ThisIsNotRocketScience/TinyGame/README.md

# TinyGame
A very very small gaming device. 
Based on a Freescale/NXP KL02 microcontroller, a 64x32 pixel black/white OLED display.
Firmware updatable through the audio jack

Soon available on www.thisisnotrocketscience.nl 

Follow our progress on [twitter](https://twitter.com/rocket_not)
