ThisIsNotRocketScience/TinyGame/ArtWork.bmp

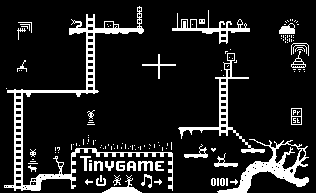
ArtWork.bmp
