ThisIsNotRocketScience/TinyGame/Design Related/Box Sleeve Design.pdf

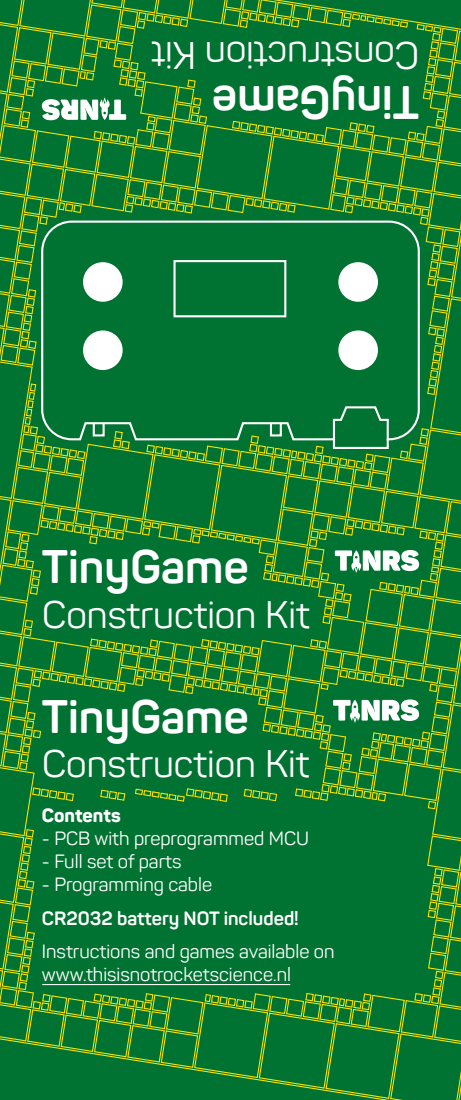
[picture p2: page 1]
TinyGame; Construction Kit

Contents
- PCB with preprogrammed MCU
- Full set of parts
- Programming cable
CR2032 battery NOT included!
Instructions and games available on
www.thisisnotrocketscience.nl
