ThisIsNotRocketScience/TinyGame/TinyCam.brd

## EAGLE design TinyCam.brd (2016-12-25)

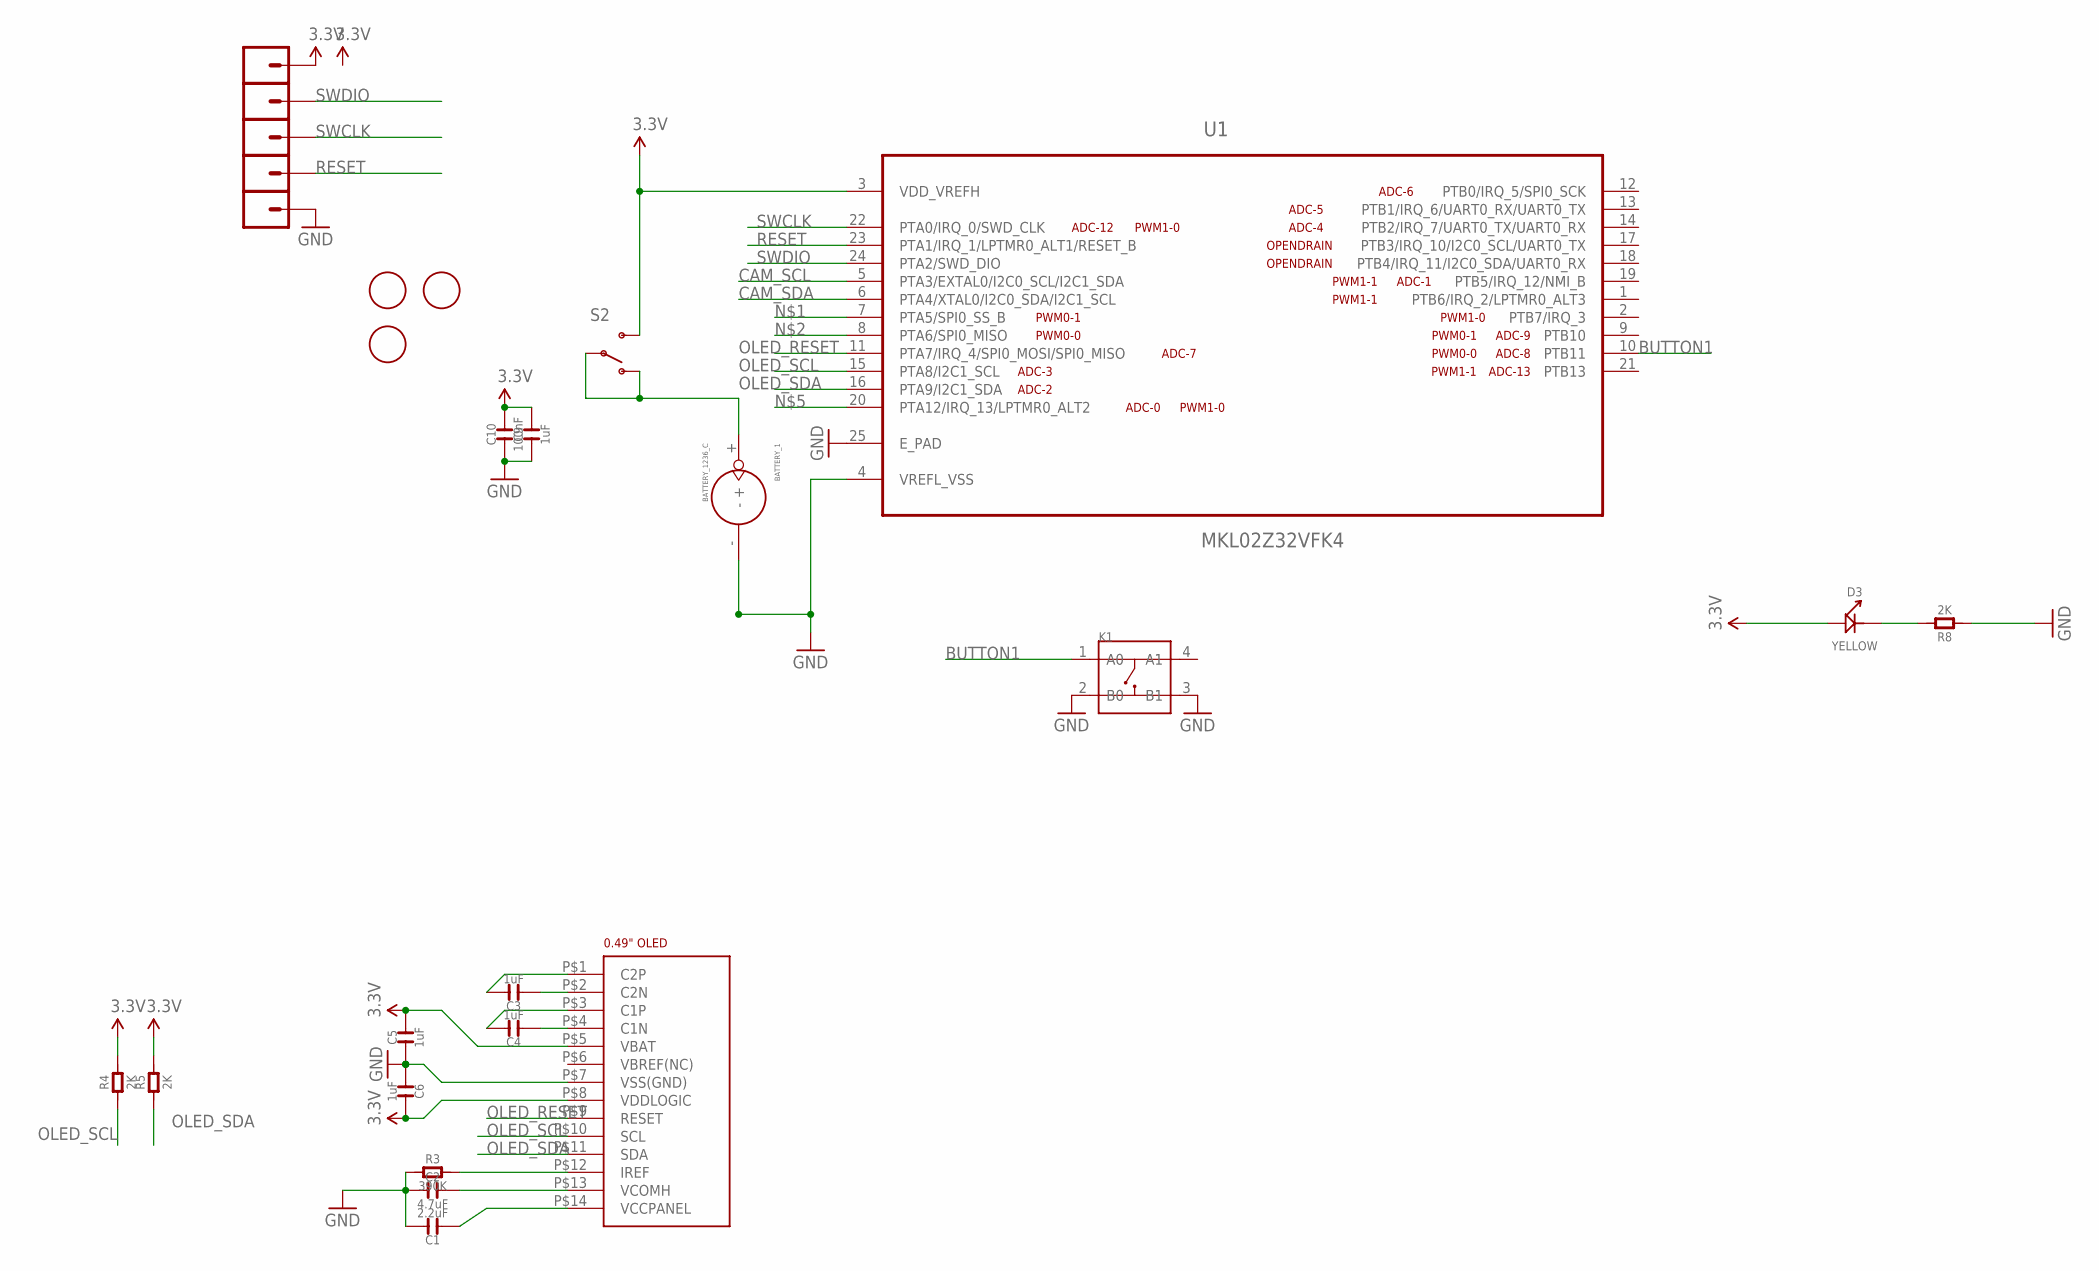
[picture p3: schematic TinyCam.sch]

Parts:
BATTERY_1: BATTERY_1236_C
C1: 2.2uF; C0603
C2: 4.7uF; C0603
C3, C4, C5, C6, C9: 1uF; C0603
C10: 100nF; C0603
D3: YELLOW; LED0603
K1: BUTTON-4P-3100010P1; 4P-SMD-6.0X6.0X5.0H
PTA6_MISO1, PTA6_MISO2, PTA6_MISO3, PTA6_MISO4, PTA6_MISO5: M01SMD-4.5X1.5; PAD-1.5X4.5
R3: 390K; R0603
R4, R5, R8: 2K; R0603
S2: SWITCH-SPDT-SMD-A; SWITCH-SPST-SMD-A
U1: MKL02Z32VFK4; QFN50P400X400X100-25N
U$1: 0.49"OLEDFOLDED; 0.49"-FPC-0.7-14-FOLDED
U$2, U$3, U$4: FIDUCIAL; FIDUCIAL_1MM

Connections:
3.3V: C5.2, C6.2, C9.2, C10.2, D3.+, PTA6_MISO1.P$1, R4.2, R5.2, S2.3 (S), U1.3 (VDD_VREFH), U$1.P$5 (VBAT), U$1.P$8 (VDDLOGIC)
BUTTON1: K1.1 (A0), U1.10 (PTB11)
CAM_SCL: U1.5 (PTA3/EXTAL0/I2C0_SCL/I2C1_SDA)
CAM_SDA: U1.6 (PTA4/XTAL0/I2C0_SDA/I2C1_SCL)
GND: BATTERY_1.-, C1.2, C2.1, C5.1, C6.1, C9.1, C10.1, K1.2 (B0), K1.3 (B1), PTA6_MISO5.P$1, R3.1, R8.1, U1.4 (VREFL_VSS), U1.25 (E_PAD), U$1.P$7 (VSS(GND))
unnamed: C3.2, U$1.P$1 (C2P)
unnamed: C4.2, U$1.P$3 (C1P)
unnamed: R3.2, U$1.P$12 (IREF)
unnamed: C1.1, U$1.P$14 (VCCPANEL)
unnamed: C2.2, U$1.P$13 (VCOMH)
unnamed: C3.1, U$1.P$2 (C2N)
unnamed: C4.1, U$1.P$4 (C1N)
unnamed: D3.-, R8.2
OLED_RESET: U1.11 (PTA7/IRQ_4/SPI0_MOSI/SPI0_MISO), U$1.P$9 (RESET)
OLED_SCL: R4.1, U1.15 (PTA8/I2C1_SCL), U$1.P$10 (SCL)
OLED_SDA: R5.1, U1.16 (PTA9/I2C1_SDA), U$1.P$11 (SDA)
RESET: PTA6_MISO4.P$1, U1.23 (PTA1/IRQ_1/LPTMR0_ALT1/RESET_B)
SWCLK: PTA6_MISO3.P$1, U1.22 (PTA0/IRQ_0/SWD_CLK)
SWDIO: PTA6_MISO2.P$1, U1.24 (PTA2/SWD_DIO)
VBAT: BATTERY_1.+, S2.1 (O), S2.2

Board: 2 copper layers, 26 parts (0 on the bottom side), 18 nets, no tracks yet.
