ThisIsNotRocketScience/TinyGame/TinyGame_RC1/TinyGame RC1_Jig.brd

## EAGLE design TinyGame_RC1/TinyGame RC1_Jig.brd (2016-12-03)

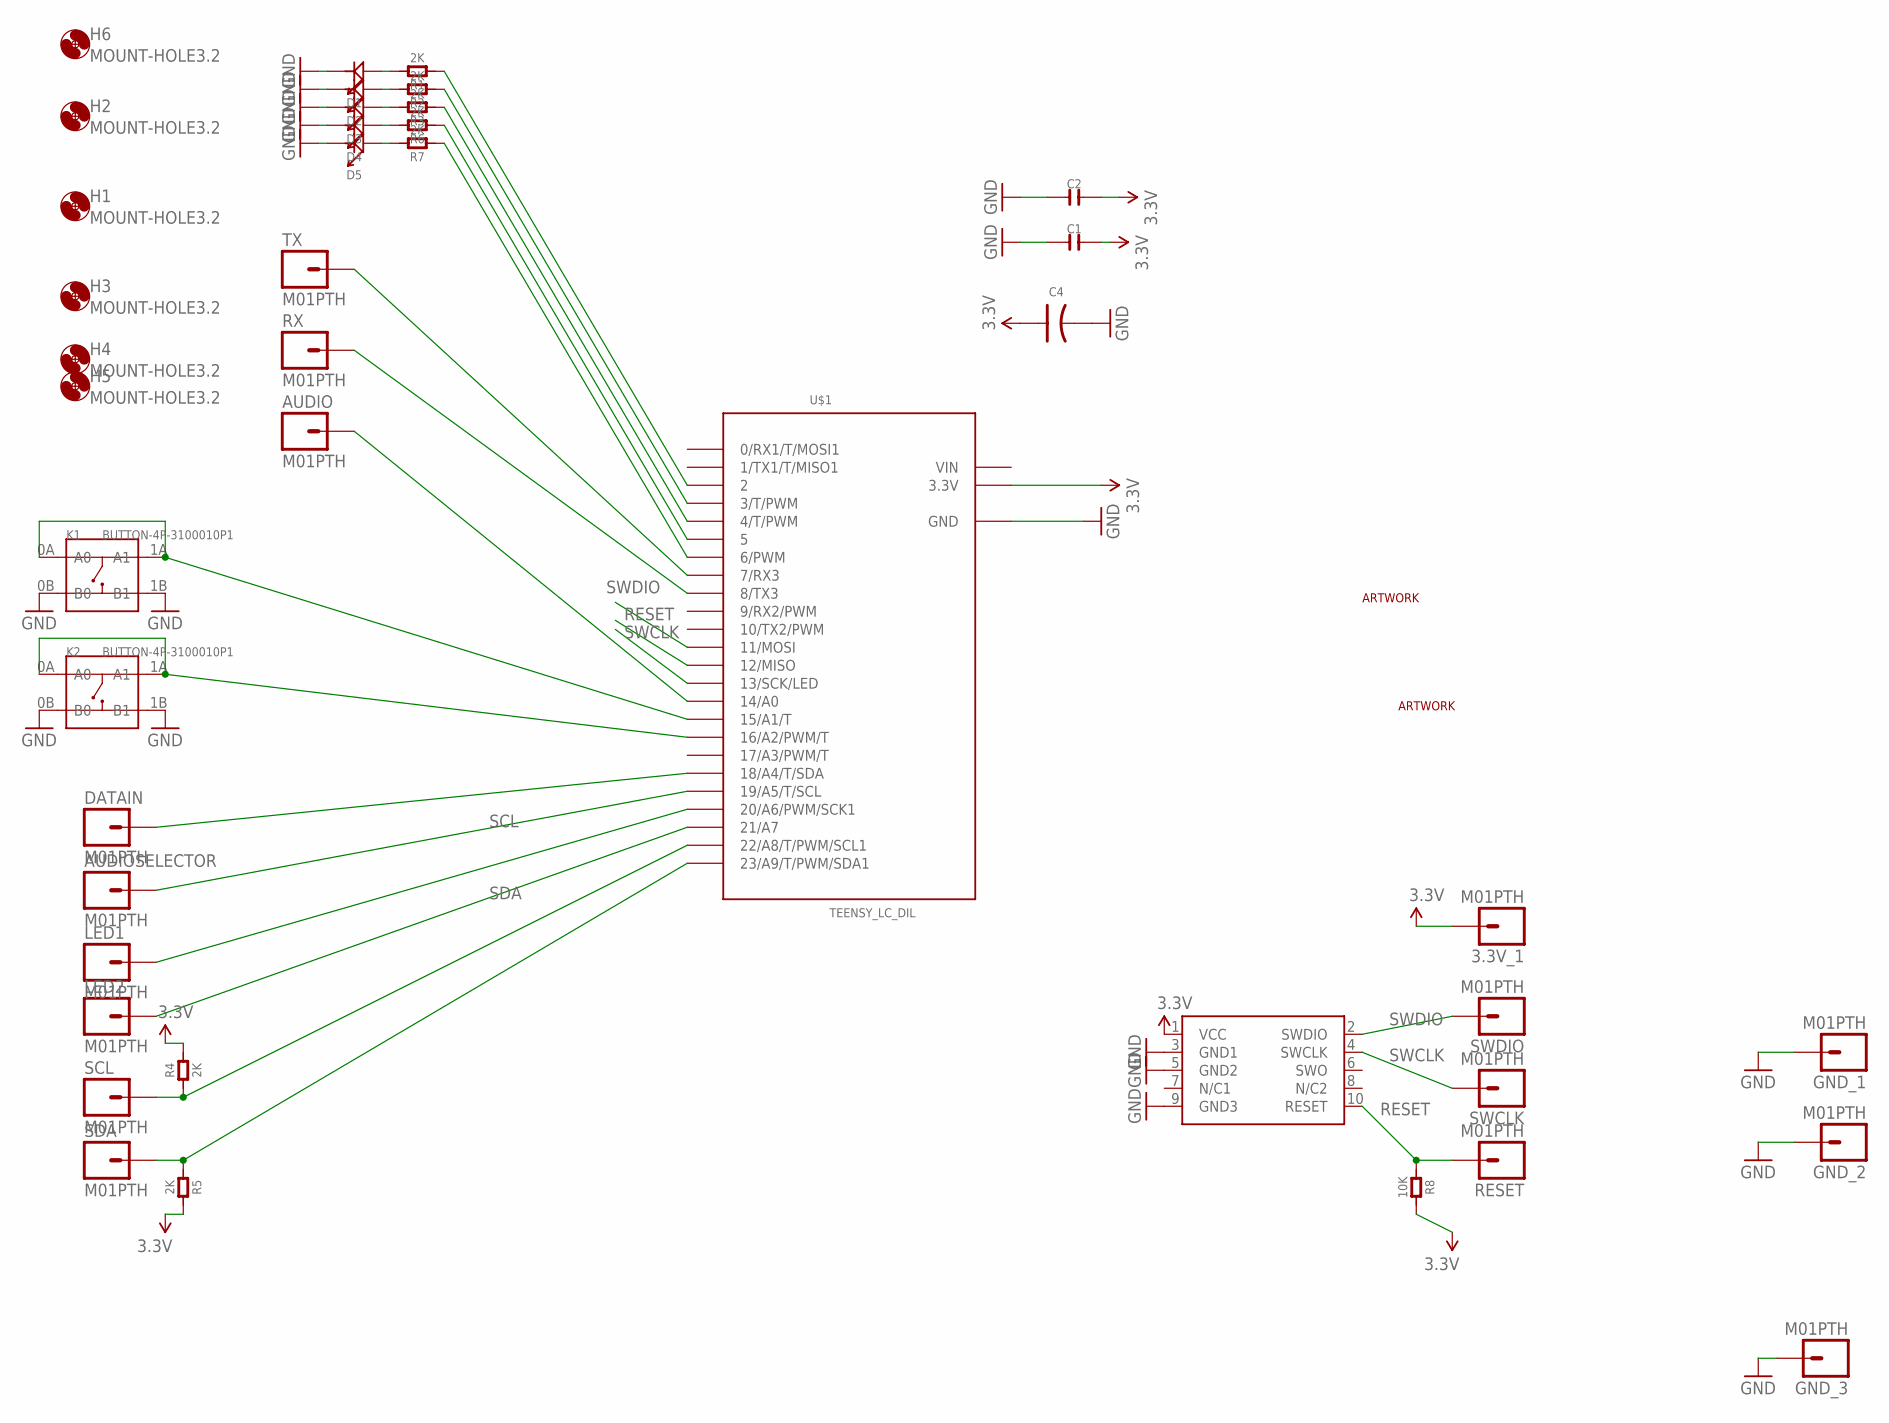
[picture p4: schematic TinyGame RC1_Jig.sch]

Parts:
3.3V_1: M01PTH; 1X01
AUDIO: M01PTH; 1X01
AUDIOSELECTOR: M01PTH; 1X01
C1, C2: C-0603; C0603
C4: C-POLAR-A; AVX-A
D1, D2, D3, D4, D5: LED; LED0603
DATAIN: M01PTH; 1X01
GND_1, GND_2, GND_3: M01PTH; 1X01
H1, H2, H3, H4, H5, H6: MOUNT-HOLE3.2; 3,2
K1, K2: BUTTON-4P-3100010P1; 4P-SMD-6.0X6.0X5.0H
LED1, LED2: M01PTH; 1X01
R1, R2, R3, R4, R5, R6, R7: 2K; R0603
R8: 10K; R0603
RESET: M01PTH; 1X01
RX: M01PTH; 1X01
SCL: M01PTH; 1X01
SDA: M01PTH; 1X01
SWCLK: M01PTH; 1X01
SWD1: CORTEX_SWDVERT; SWD_VERTICAL
SWDIO: M01PTH; 1X01
TX: M01PTH; 1X01
U$1: TEENSY_LC_DIL; TEENSY_3.0-3.2&LC_DIL
U$2: TINRS_ARTWORKLOGO; TINRSLOGO
U$3: TINRS_ARTWORKROCKET; TINRS_ROCKET

Connections:
3.3V: 3.3V_1.1, C1.2, C2.2, C4.+ (1), R4.2, R5.2, R8.2, SWD1.1 (VCC), U$1.3.3V
GND: C1.1, C2.1, C4.- (2), D1.-, D2.-, D3.-, D4.-, D5.-, GND_1.1, GND_2.1, GND_3.1, K1.0B (B0), K1.1B (B1), K2.0B (B0), K2.1B (B1), SWD1.3 (GND1), SWD1.5 (GND2), SWD1.9 (GND3), U$1.AGND (GND), U$1.GND
unnamed: TX.1, U$1.7 (7/RX3)
unnamed: RX.1, U$1.8 (8/TX3)
unnamed: AUDIO.1, U$1.14/A0
unnamed: LED2.1, U$1.21/A7
unnamed: LED1.1, U$1.20/A6 (20/A6/PWM/SCK1)
unnamed: AUDIOSELECTOR.1, U$1.19/A5 (19/A5/T/SCL)
unnamed: DATAIN.1, U$1.18/A4 (18/A4/T/SDA)
unnamed: R1.1, U$1.2
unnamed: R2.1, U$1.3 (3/T/PWM)
unnamed: R3.1, U$1.4 (4/T/PWM)
unnamed: R6.1, U$1.5
unnamed: R7.1, U$1.6 (6/PWM)
unnamed: D1.+, R1.2
unnamed: D2.+, R2.2
unnamed: D3.+, R3.2
unnamed: D4.+, R6.2
unnamed: D5.+, R7.2
unnamed: K1.0A (A0), K1.1A (A1), U$1.15/A1 (15/A1/T)
unnamed: K2.0A (A0), K2.1A (A1), U$1.16/A2 (16/A2/PWM/T)
RESET: R8.1, RESET.1, SWD1.10 (RESET), U$1.12 (12/MISO)
SCL: R4.1, SCL.1, U$1.22/A8 (22/A8/T/PWM/SCL1)
SDA: R5.1, SDA.1, U$1.23/A9 (23/A9/T/PWM/SDA1)
SWCLK: SWCLK.1, SWD1.4 (SWCLK), U$1.13 (13/SCK/LED)
SWDIO: SWD1.2 (SWDIO), SWDIO.1, U$1.11 (11/MOSI)
VIN: U$1.VIN

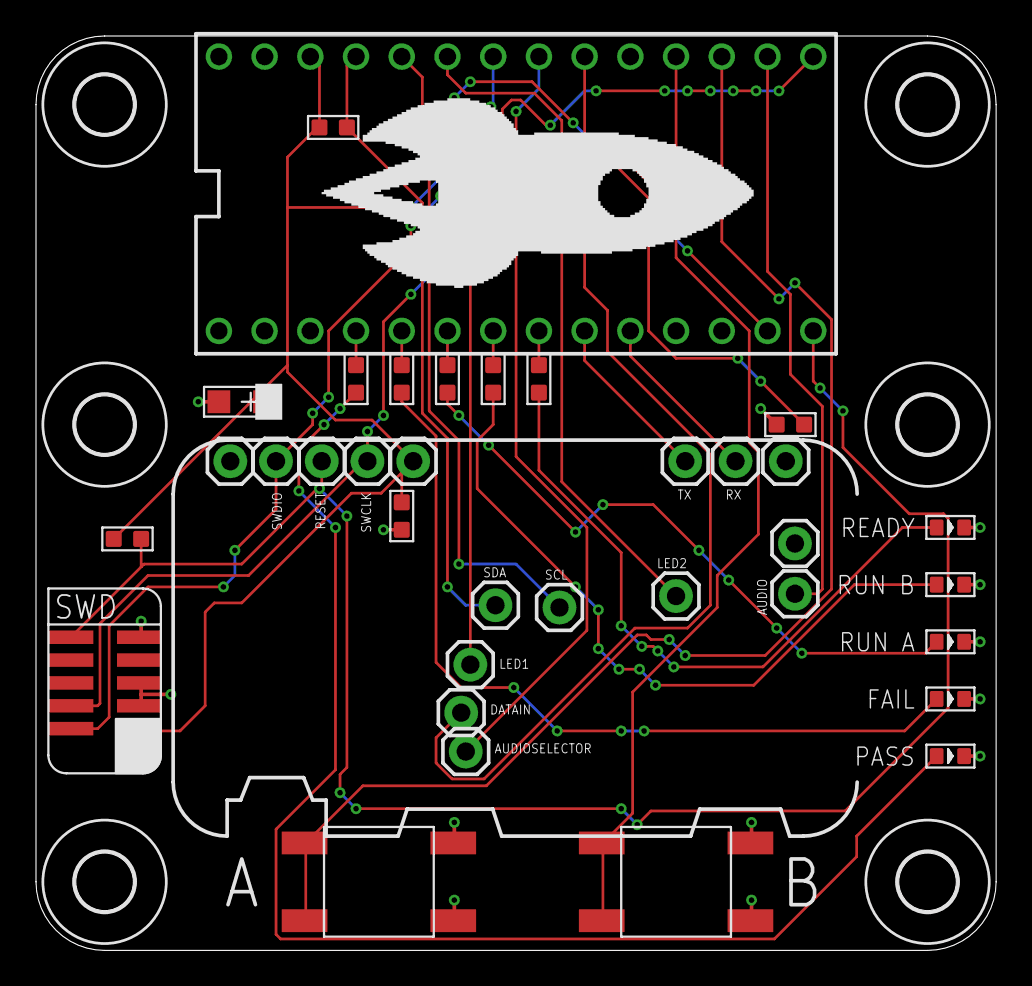
[picture p5: board TinyGame RC1_Jig.brd from above]

Board: 2 copper layers, 53.3 x 50.8 mm, 44 parts (1 on the bottom side), 26 nets.
