ThisIsNotRocketScience/TinyGame/TinyGame_RC1/TinyGame RC1_JTAG.brd

## EAGLE design TinyGame_RC1/TinyGame RC1_JTAG.brd (2016-12-03)

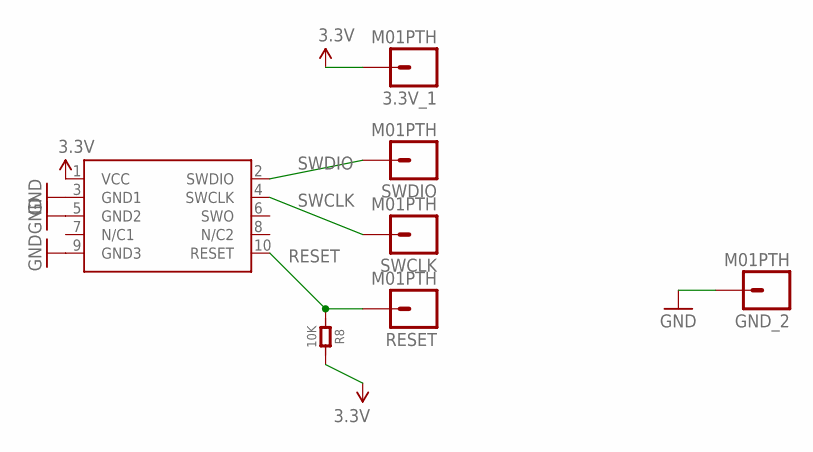
[picture p6: schematic TinyGame RC1_JTAG.sch]

Parts:
3.3V_1: M01PTH; 1X01
GND_2: M01PTH; 1X01
R8: 10K; R0603
RESET: M01PTH; 1X01
SWCLK: M01PTH; 1X01
SWD1: CORTEX_SWDVERT; SWD_VERTICAL
SWDIO: M01PTH; 1X01

Connections:
3.3V: 3.3V_1.1, R8.2, SWD1.1 (VCC)
GND: GND_2.1, SWD1.3 (GND1), SWD1.5 (GND2), SWD1.9 (GND3)
RESET: R8.1, RESET.1, SWD1.10 (RESET)
SWCLK: SWCLK.1, SWD1.4 (SWCLK)
SWDIO: SWD1.2 (SWDIO), SWDIO.1

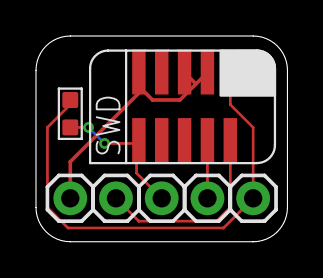
[picture p7: board TinyGame RC1_JTAG.brd from above]

Board: 2 copper layers, 14.0 x 11.4 mm, 7 parts (0 on the bottom side), 5 nets.
