ThisIsNotRocketScience/TinyGame/MicroOLEDWithKL02.brd

## EAGLE design TinyGame_Legacy/TinyGame1.brd (2015-11-25, an earlier design)

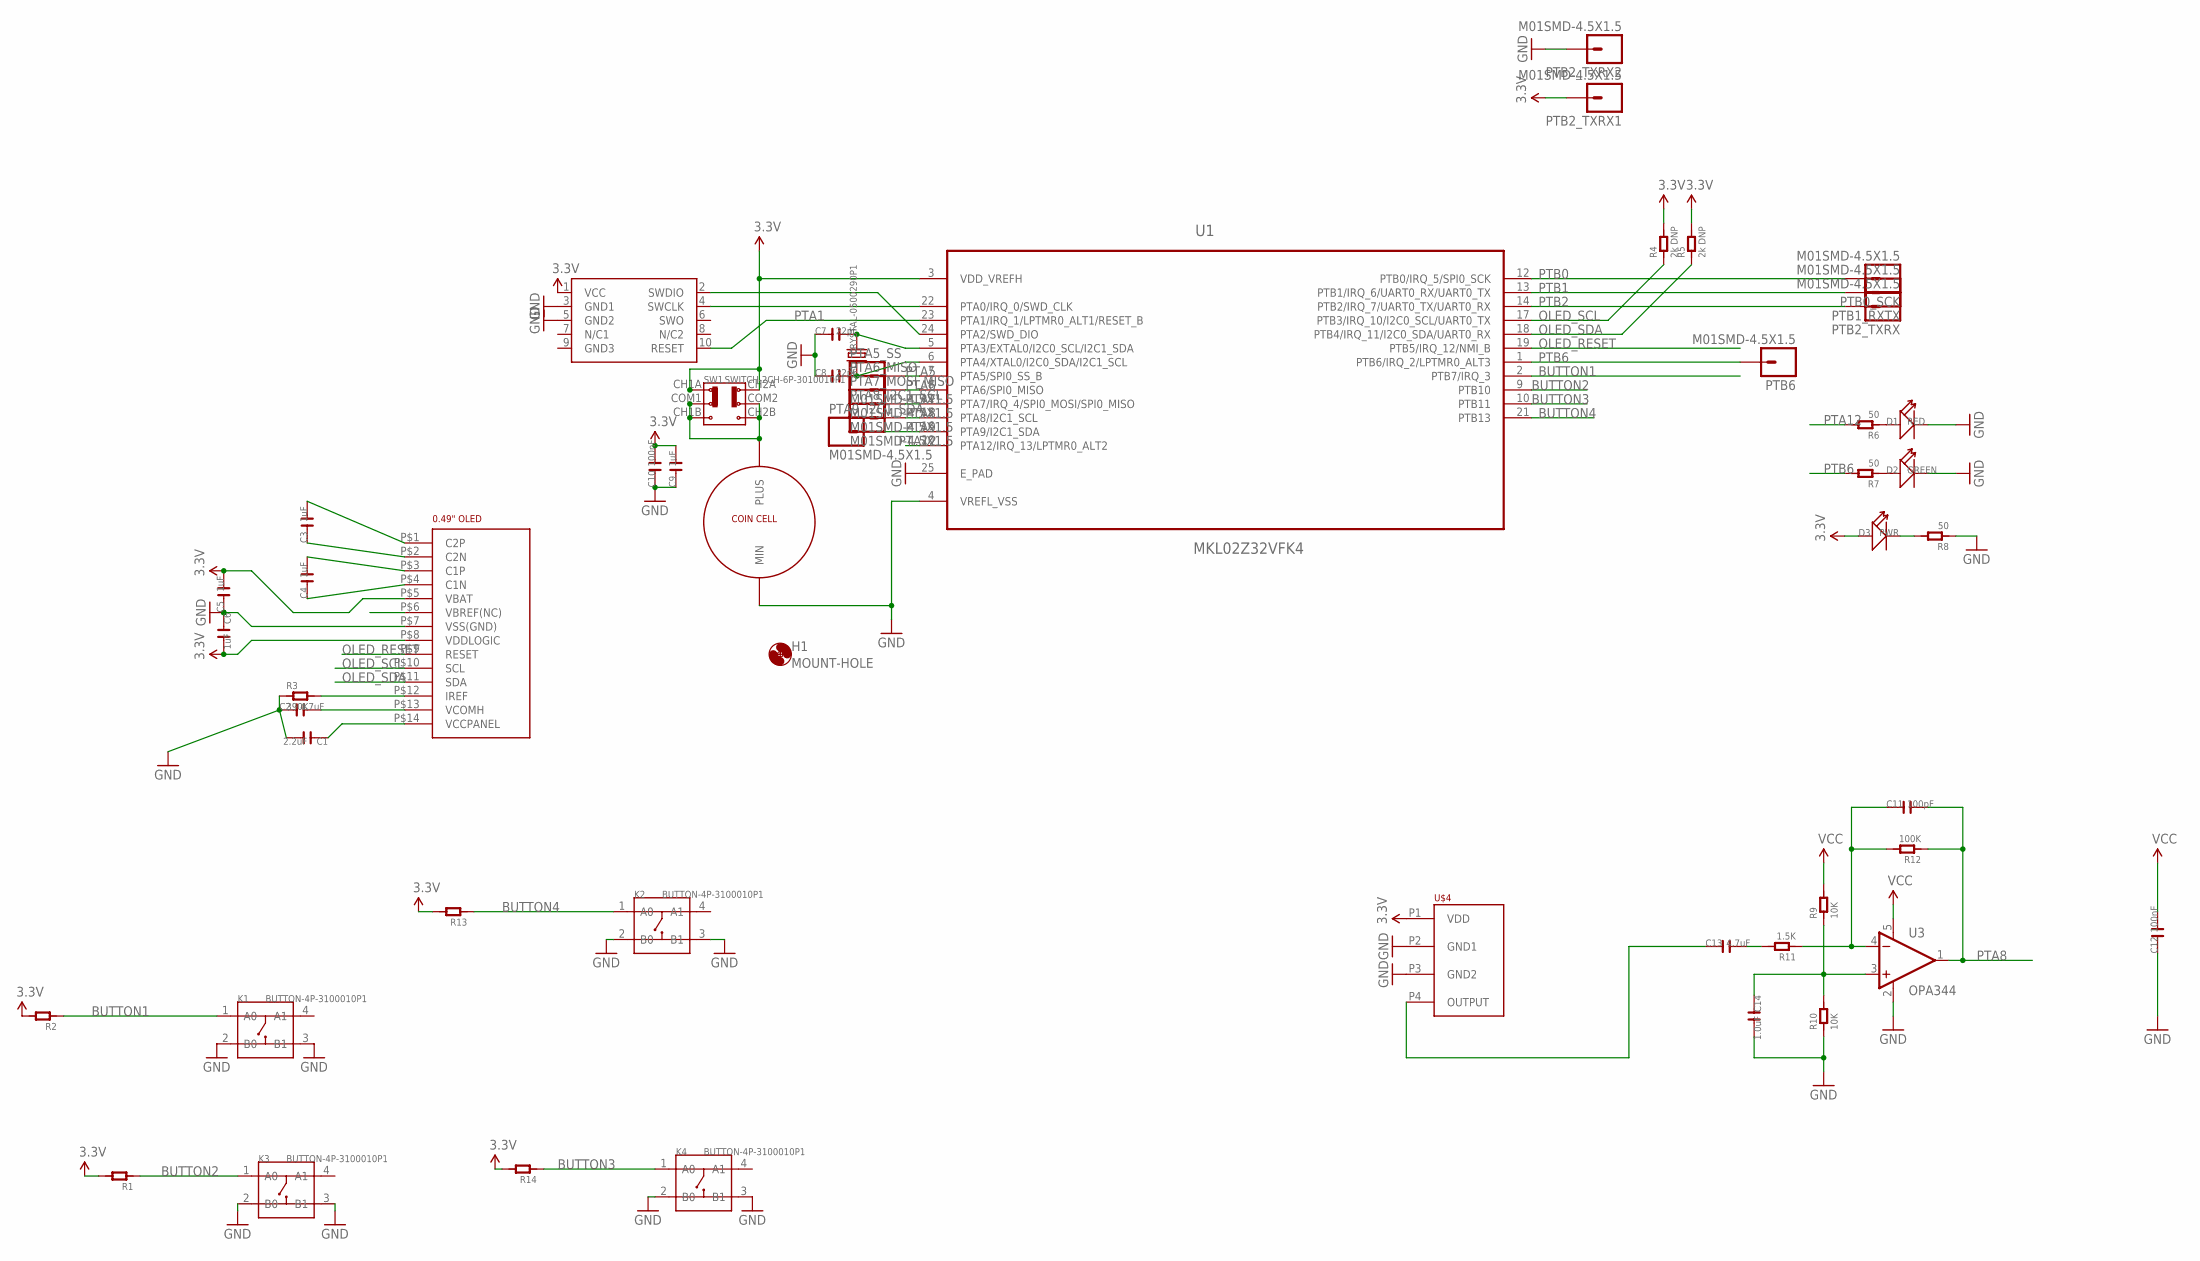
[picture p8: schematic TinyGame1.sch]

Parts:
C1: 2.2uF; C0805
C2: 4.7uF; C0805
C3, C4, C5, C6, C9: 1uF; C0603
C7, C8: 22pf; C0603
C10, C12: 100nF; C0603
C11: 100pF; C0603
C13: 4.7uF; C0603
C14: 1.0uF; C0603
D1: RED; LED0603
D2: GREEN; LED0603
D3: PWR; LED0603
H1: MOUNT-HOLE; 3.2-NOMARKINGS-SMALLSAFEZONE
K1, K2, K3, K4: BUTTON-4P-3100010P1; 4P-SMD-6.0X6.0X5.0H
PTA5_SS, PTA6_MISO, PTA7_MOSI_MISO, PTA8_I2C1_SCL, PTA9_I2C1_SDA: M01SMD-4.5X1.5; PAD-1.5X4.5
PTB0_SCK, PTB1_RXTX, PTB2_TXRX, PTB2_TXRX1, PTB2_TXRX2, PTB6: M01SMD-4.5X1.5; PAD-1.5X4.5
R1, R2, R13, R14: R-0603; R0603
R3: 390K; R0603
R4, R5: 2k DNP; R0603
R6, R7, R8: 50; R0603
R9, R10: 10K; R0603
R11: 1.5K; R0603
R12: 100K; R0603
SW1: SWITCH-2CH-6P-3010010P1; 6P-2CH-2.54-9.1X3.5X3.2+2H
SWD1: CORTEX_SWD; M50-3600542
U1: MKL02Z32VFK4; QFN50P400X400X100-25N
U3: OPA344; SOT23-5
U$1: 0.49"OLED; FPC-0.7-14
U$4: WM7120A; LGAMS4
U$5: COINCELL; 2032HOLDER-SZ
X1: CRYSTAL-0500290P1; 2P-SMD-5.0X3.2

Connections:
3.3V: C5.2, C6.2, C9.2, C10.2, C12.2, D3.+, PTB2_TXRX1.P$1, R1.2, R2.2, R4.2, R5.2, R9.2, R13.2, R14.2, SW1.CH1A, SW1.CH2A, SWD1.1 (VCC), U1.3 (VDD_VREFH), U3.5 (V+), U$1.P$5 (VBAT), U$1.P$8 (VDDLOGIC), U$4.P1 (VDD)
BUTTON1: K1.1 (A0), R2.1, U1.2 (PTB7/IRQ_3)
BUTTON2: K3.1 (A0), R1.1, U1.9 (PTB10)
BUTTON3: K4.1 (A0), R14.1, U1.10 (PTB11)
BUTTON4: K2.1 (A0), R13.1, U1.21 (PTB13)
GND: C1.2, C2.1, C5.1, C6.1, C7.1, C8.1, C9.1, C10.1, C12.1, C14.2, D1.-, D2.-, K1.2 (B0), K1.3 (B1), K2.2 (B0), K2.3 (B1), K3.2 (B0), K3.3 (B1), K4.2 (B0), K4.3 (B1), PTB2_TXRX2.P$1, R3.1, R8.1, R10.1, SWD1.3 (GND1), SWD1.5 (GND2), U1.4 (VREFL_VSS), U1.25 (E_PAD), U3.2 (V-), U$1.P$7 (VSS(GND)), U$4.P2 (GND1), U$4.P3 (GND2), U$5.MIN
unnamed: C7.2, U1.5 (PTA3/EXTAL0/I2C0_SCL/I2C1_SDA), X1.2
unnamed: C8.2, U1.6 (PTA4/XTAL0/I2C0_SDA/I2C1_SCL), X1.1
unnamed: C3.2, U$1.P$1 (C2P)
unnamed: C4.2, U$1.P$3 (C1P)
unnamed: SWD1.4 (SWCLK), U1.22 (PTA0/IRQ_0/SWD_CLK)
unnamed: D1.+, R6.1
unnamed: SWD1.2 (SWDIO), U1.24 (PTA2/SWD_DIO)
unnamed: R3.2, U$1.P$12 (IREF)
unnamed: C1.1, U$1.P$14 (VCCPANEL)
unnamed: C2.2, U$1.P$13 (VCOMH)
unnamed: C3.1, U$1.P$2 (C2N)
unnamed: C4.1, U$1.P$4 (C1N)
unnamed: D2.+, R7.1
unnamed: C13.1, U$4.P4 (OUTPUT)
unnamed: C11.1, R11.1, R12.2, U3.4 (-IN)
unnamed: C13.2, R11.2
unnamed: C14.1, R9.1, R10.2, U3.3 (+IN)
unnamed: D3.-, R8.2
unnamed: SW1.CH1B, SW1.CH2B, SW1.COM1, SW1.COM2, U$5.PLUS
OLED_RESET: U1.19 (PTB5/IRQ_12/NMI_B), U$1.P$9 (RESET)
OLED_SCL: R4.1, U1.17 (PTB3/IRQ_10/I2C0_SCL/UART0_TX), U$1.P$10 (SCL)
OLED_SDA: R5.1, U1.18 (PTB4/IRQ_11/I2C0_SDA/UART0_RX), U$1.P$11 (SDA)
PTA1: SWD1.10 (RESET), U1.23 (PTA1/IRQ_1/LPTMR0_ALT1/RESET_B)
PTA5: PTA5_SS.P$1, U1.7 (PTA5/SPI0_SS_B)
PTA6: PTA6_MISO.P$1, U1.8 (PTA6/SPI0_MISO)
PTA7: PTA7_MOSI_MISO.P$1, U1.11 (PTA7/IRQ_4/SPI0_MOSI/SPI0_MISO)
PTA8: C11.2, PTA8_I2C1_SCL.P$1, R12.1, U1.15 (PTA8/I2C1_SCL), U3.1 (OUT)
PTA9: PTA9_I2C1_SDA.P$1, U1.16 (PTA9/I2C1_SDA)
PTA12: R6.2, U1.20 (PTA12/IRQ_13/LPTMR0_ALT2)
PTB0: PTB0_SCK.P$1, U1.12 (PTB0/IRQ_5/SPI0_SCK)
PTB1: PTB1_RXTX.P$1, U1.13 (PTB1/IRQ_6/UART0_RX/UART0_TX)
PTB2: PTB2_TXRX.P$1, U1.14 (PTB2/IRQ_7/UART0_TX/UART0_RX)
PTB6: PTB6.P$1, R7.2, U1.1 (PTB6/IRQ_2/LPTMR0_ALT3)

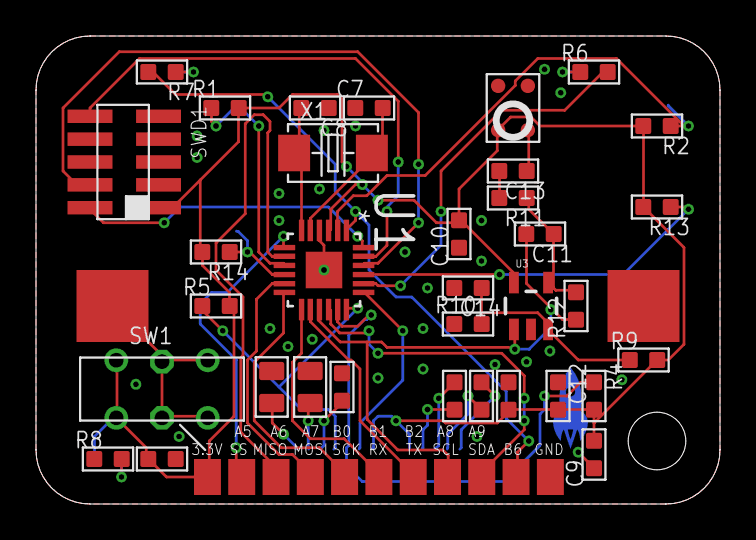
[picture p9: board TinyGame1.brd from above]

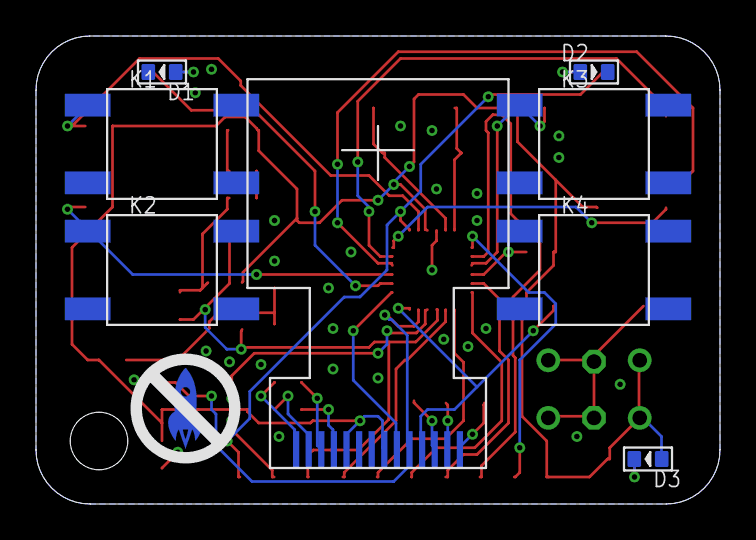
[picture p10: board TinyGame1.brd from below]

Board: 2 copper layers, 38.0 x 26.0 mm, 56 parts (9 on the bottom side), 39 nets.

Other parts of the board:
U$2: SMALLROCKET
