ThisIsNotRocketScience/TinyGame/Code/KL02MiniGameBoy1/Sources/Track.h

/*
 * Track.h
 *
 *  Created on: 26 sep. 2014
 *      Author: Stijn
 */

#ifndef TRACK_H_
#define TRACK_H_

static const
unsigned char const  track1[] =
{
	0x00,0x00,0x00,0x00,0x00,0x00,0x00,0x00
,0x00,0x00,0x00,0x00,0x00,0x00,0x00,0x00
,0x00,0x00,0x00,0x00,0x00,0x00,0x00,0x00
,0x00,0x00,0x00,0x00,0x00,0x00,0x00,0x00
,0x00,0x00,0x00,0x00,0x00,0x00,0x00,0x00
,0x00,0x00,0x00,0x00,0x4C
,0x00,0x00,0x00,0x00,0x00,0x00,0x00,0x00
,0x00,0x00,0x00,0x00,0x00,0x00,0x00,0x00
,0x00,0x00,0x00,0x00,0x00,0x00,0x00,0x00
,0x00,0x00,0x00,0x00,0x00,0x00,0x00,0x00
,0x00,0x00,0x00,0x00,0x00,0x00,0x00,0x00
,0x00,0x00,0x00,0x00,0x42
,0x00,0x00,0x00,0x00,0x00,0x00,0x00,0x00
,0x00,0x00,0x00,0x00,0x00,0x00,0x00,0x00
,0x00,0x00,0x00,0x00,0x00,0x00,0x00,0x00
,0x00,0x00,0x00,0x00,0x00,0x00,0x00,0x00
,0x00,0x00,0x00,0x00,0x00,0x00,0x00,0x00
,0x00,0x00,0x00,0x00,0x32
,0x10,0x00,0x00,0x00,0xCC
,0x10,0x00,0x00,0x00,0xC2
,0x10,0x00,0x00,0x00,0xB2
,0x18,0x00,0x00,0x00,0x4C
,0x18,0x00,0x00,0x00,0x42
,0x18,0x00,0x00,0x00,0x32
,0x28,0x00,0x00,0x00,0xCC
,0x28,0x00,0x00,0x00,0xC2
,0x28,0x00,0x00,0x00,0xB2
,0x48,0x00,0x00,0x00,0x4C
,0x48,0x00,0x00,0x00,0x42
,0x48,0x00,0x00,0x00,0x32
,0x58,0x00,0x00,0x00,0xCC
,0x58,0x00,0x00,0x00,0xC2
,0x58,0x00,0x00,0x00,0xB2
,0x78,0x00,0x00,0x00,0x48
,0x78,0x00,0x00,0x00,0x42
,0x78,0x00,0x00,0x00,0x32
,0x88,0x00,0x00,0x00,0xC8
,0x88,0x00,0x00,0x00,0xC2
,0x88,0x00,0x00,0x00,0xB2
,0x90,0x00,0x00,0x00,0x4C
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
};

#endif /* TRACK_H_ */
