ThisIsNotRocketScience/TinyGame/(commit log)

2015-11-25 Boards committed..
    [MicroOLEDWithKL02-r2.brd, MicroOLEDWithKL02-r2.sch, MicroOLEDWithKL02.brd, MicroOLEDWithKL02.sch, TinyMicroGameboy-smallbuttons.brd, TinyMicroGameboy-smallbuttons.sch, TinyMicroGameboy.brd, TinyMicroGameboy.sch]
2016-11-12 Added TinyGame RC1 to the repo
    [MicroGameboy R3 w HeadPhone.GBL, MicroGameboy R3 w HeadPhone.GBO, MicroGameboy R3 w HeadPhone.GBP, MicroGameboy R3 w HeadPhone.GBS, MicroGameboy R3 w HeadPhone.GKO, MicroGameboy R3 w HeadPhone.GTL, MicroGameboy R3 w HeadPhone.GTO, MicroGameboy R3 w HeadPhone.GTP]
2016-11-16 Moved some stuff around - added testjig and jtag adapter
    [TinyGame RC1.GBL, TinyGame RC1.GBO, TinyGame RC1.GBP, TinyGame RC1.GBS, TinyGame RC1.GKO, TinyGame RC1.GTL, TinyGame RC1.GTO, TinyGame RC1.GTP]
2016-11-28 Many Tiny Updates
    [TinyGame RC2.GBL, TinyGame RC2.GBO, TinyGame RC2.GBP, TinyGame RC2.GBS, TinyGame RC2.GKO, TinyGame RC2.GTL, TinyGame RC2.GTO, TinyGame RC2.GTP]
2016-11-30 RC2 design update for programming
    [TinyGame RC2.GBL, TinyGame RC2.GBO, TinyGame RC2.GBP, TinyGame RC2.GBS, TinyGame RC2.GKO, TinyGame RC2.GTL, TinyGame RC2.GTO, TinyGame RC2.GTP]
2016-12-02 TinyGame ArtUpdate
    [TinyGame RC2.GBL, TinyGame RC2.GBO, TinyGame RC2.GBP, TinyGame RC2.GBS, TinyGame RC2.GKO, TinyGame RC2.GTL, TinyGame RC2.GTO, TinyGame RC2.GTP]
2016-12-03 Artwork and gerbers
    [TinyGame RC1_JTAG.GBL, TinyGame RC1_JTAG.GBO, TinyGame RC1_JTAG.GBP, TinyGame RC1_JTAG.GBS, TinyGame RC1_JTAG.GKO, TinyGame RC1_JTAG.GTL, TinyGame RC1_JTAG.GTO, TinyGame RC1_JTAG.GTP]
2017-01-04 TinyGame boot system progress
    [TinyGame RC2.csv]
